bdureau/AltiUno/AltiUnoAlternativeFirmware/Readme.md

This folder contains alternative firmwares that can be used by the AltiUno board.
