bdureau/AltiUno/schema/Alti Uno mini.png

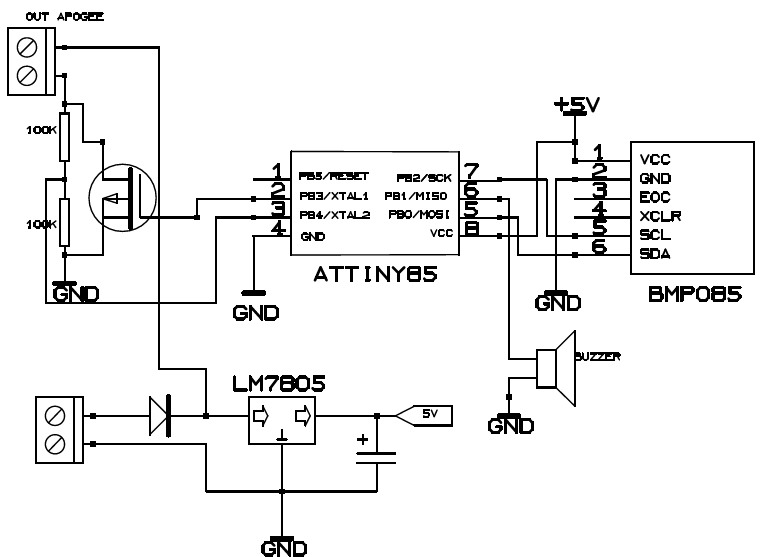
schema/Alti Uno mini.png
